Lucas-byte31/Greenhouse/02_SW_SPEC/Schema de cablage.pptx

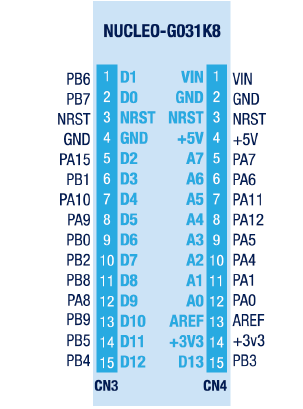
[picture p20: figure]

Écran LCD

PB6 et PB7 (GPIO OUT)

Alimentation 5VDC

Écran LCD

PB1 (GPIO OUT)

PB1

PB2

PA7 (GPIO IN)

IN1

Carte moteur

IN3

IN4

De PB9

De PB5

Capteur Température

Capteur Humidité

PB3

PA6 (GPIO IN)

PA11 (GPIO IN)

IN2

Écran LCD

PB0, PB2 et PB8
(GPIO OUT)

Vers IN3

PA1 (ADC1_IN1)

Pompe

Ventilateur

Vers IN4

Vers IN3

PA0 (ADC1_IN0)

PB4 (GPIO OUT)

PB3 (GPIO OUT)

## Slide 2

Carte moteur SBC-MotorDriver2

FAN

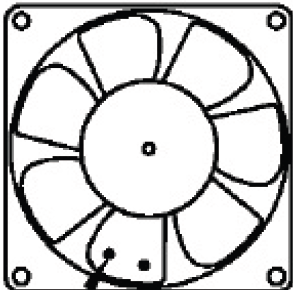
[picture p21: figure]

+

GND

GND

+

GPIO_OUT

PWM (TIM16_CH1)

+

GND

IN1

IN2

IN3

IN4

Alim 5-12V

## Slide 3

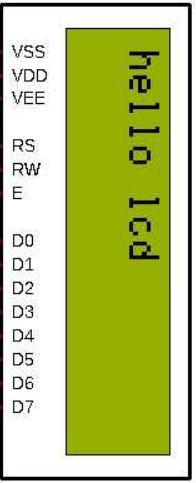
[picture p22: figure]

A

K
