Lucas-byte31/Greenhouse/02_SW_SPEC/Matériel.xlsx

Projet Greenhouse - Serre connectée
composants utilisés: | Composant | Référence | Alimentation | Courant d'usage
 | Microprocesseur | stm32g031k8 | 1.7 - 3.6V | 20mA max / broche
 | Capteur d’humidité Type SeedStudio | 101020614 | 3.3 - 5V | -
 | Capteur de température | Basé LM35, DHT22, thermistance ou équivalent | 2.3 - 5.5V | -
 | Ecran | HD44780U LCD 2x16 parallèle ou équivalent | 2.7 - 4.5V | 150mA
 | Pompe à eau | FIT0910 | 3 - 6 V | 150 - 370mA
 | Ventilateur | MF40100V2 | 3.5 - 6V | 155 - 179mA
 | Carte moteur | MotoDriver2 (5V-24V, double canal, contrôle digital) | 5 - 35V | 2A Max
 | Boutons poussoirs
 | (3+)
 | Alimentation
 | Connecteurs
