Lucas-byte31/Greenhouse/04_SW_CODE/MX_Project/Core/Src/main.c

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
/* Includes ------------------------------------------------------------------*/
#include "main.h"

/* USER CODE BEGIN Includes */
#include <motor_driver_fan.h>
#include <motor_driver_pump.h>
#include "capteurs.h"
#include "lcd.h"
#include "lcd_page_manager.h"
#include "filter.h"
#include "error_handler.h"
#include <stdio.h>
#include <stdlib.h>
#include <string.h>
/* USER CODE END Includes */

/* USER CODE BEGIN PD */

/* Calibration humidite SEN0193 - base DFRobot adaptée en 12 bits */

/* USER CODE END PD */

ADC_HandleTypeDef hadc1;

TIM_HandleTypeDef htim3;

UART_HandleTypeDef huart2;

//Flags d'interruption pour les boutons poussoir : mis à TRUE par IT GPIO
// Mis à FALSE par le main
volatile bool PB1_pressed = false;   // Flag PB1 - Bouton rouge - navigation dans les menus
volatile bool PB2_pressed = false;   // Flag PB2 - Bouton blanc - Incrémentation consigne ou Forcage manuel
volatile bool PB3_pressed = false;   // Flag PB3 - Bouton vert - Décrémentation consigne ou Forcage manuel
void SystemClock_Config(void);
static void MX_GPIO_Init(void);
static void MX_USART2_UART_Init(void);
static void MX_ADC1_Init(void);
static void MX_TIM3_Init(void);
/* USER CODE BEGIN PFP */
void HAL_TIM_MspPostInit(TIM_HandleTypeDef *htim); //prototype de HAL_TIM_MspPostInit pour éviter warning

float TMP235_linear(float voltage);
float humidity_from_raw(uint32_t raw);
uint32_t ReadADC_Channel(uint32_t channel);

#define V_REF      3.3f		 // Vref 3.3V
#define V_OFFSET   0.130f    // offset mesure a 0V

#define AIR_VALUE   2675.0f  // mesure en air sec
#define WATER_VALUE 1780.0f  // mesure dans l'eau
/* USER CODE END PFP */

/* USER CODE BEGIN 0 */

static lcd_state_t lcd_prev = {0};
static lcd_state_t lcd_curr = {0};

/* USER CODE END 0 */

/**
  * @brief  The application entry point.
  * @retval int
  */
int main(void)
{

  /* MCU Configuration--------------------------------------------------------*/

  /* Reset of all peripherals, Initializes the Flash interface and the Systick. */
  HAL_Init();

  /* Configure the system clock */
  SystemClock_Config();

  /* Initialize all configured peripherals */
  MX_GPIO_Init();
  MX_USART2_UART_Init();
  MX_ADC1_Init();
  MX_TIM3_Init();

  /* USER CODE BEGIN 2 */

  // On initialise le moteur a OFF
  Motor_Off();
  // On initialise la pompe a OFF
  Pump_Init(); // init de la pompe
  
  //--Paramètres de régulation par défaut--//
  static int Var_page = 1; // page affichée au démarrage
  static int seuil_temperature = 25;  // Seuil de température par défaut
  static int seuil_humidite = 18;     // Seuil d'humidité par défaut
  static int code_erreur = 0; //init du code erreur à 0
  uint8_t speed = 0;  // Variable pour la vitesse de la pompe (0-100) en %


  //--Configuration du PWM pour la pompe--//
  //--Calcul de la rampe linéaire à l'approche du seuil d'humidité--//
  float x1 = 0.55f;  // 0.55*seuil_humidite → speed = 100
  float y1 = 100.0f;
  float x2 = 1.0f;  // 1.0*seuil_humidite → speed = 50
  float y2 = 50.0f;
  // Calcul des coefficients m et b de la droite y = mx + b
  float m = (y2 - y1) / (x2 - x1);
  float b = y1 - m * x1;

  // Initialisation LCD
  lcd_init();
  lcd_clear();
  static uint32_t last_lcd_update = 0;

  // Affichage
  lcd_position_cursor(0,0);
  lcd_show_txt("HELLO WORLD");

  lcd_position_cursor(0,1);
  lcd_show_txt("STM32G031U");

  // Pour debug avec printf -- pas besoin en opérationnel
  /*char buffert[80];
  char bufferh[80];*/



 //- Filtrage sur moyenne glissante pour éviter le clear intempestif du LCD --//
  // Init Moyenne glissante
  static int t_display = 0; // température affichée
  static int h_display = 0; // humidité affichée

  #define TEMP_DEADBAND 1 // 1 °C de DEADBAND
  #define HUM_DEADBAND  2 // 2 % de DEADBAND

  moving_avg_filter_t temp_filter;
  moving_avg_filter_t hum_filter;
  //Moyenne glissante sur 8 échantillons pour stabiliser l'affichage sur le LCD
  filter_init(&temp_filter, 8, seuil_temperature); //init du filtre au seuil_temperature
  filter_init(&hum_filter, 8, seuil_humidite); //init du filtre au seuil humidite

  	 // Init de l'Error Handler
  error_handler_init(seuil_temperature, seuil_humidite); // Init de l'error handler
  /* USER CODE END 2 */

  /* Infinite loop */
  /* USER CODE BEGIN WHILE */
  while (1)
  {

	  // Connaitre l'instant présent - utilisé dans l'error handler et dans le rafraichissement du LCD
      uint32_t now = HAL_GetTick();

	  /* ================== HUMIDITE sur PA0 = ADC1_IN0 ================== */
	      uint32_t raw_hum = ReadADC_Channel(ADC_CHANNEL_0);
	      float humidity = CAPTEURS_ComputeHumidity(raw_hum, AIR_VALUE, WATER_VALUE);

	      int h100 = (int)(humidity * 100.0f);
	      int h_int = h100 / 100;
	      //int h_dec = abs(h100 % 100); //utilisée que pour le debug

	      /*Pour le debug
	      sprintf(bufferh,
	              "H: rawHum=%lu  Humidite=%d.%02d %%\r\n",
	              raw_hum, h_int, h_dec);
	      HAL_UART_Transmit(&huart2, (uint8_t*)bufferh, strlen(bufferh), HAL_MAX_DELAY);*/


	      /* ============== TEMPERATURE sur PA1 = ADC1_IN1 (TMP235) ============== */
	      uint32_t raw_temp = ReadADC_Channel(ADC_CHANNEL_1);
	      float temperature = CAPTEURS_ComputeTemperature(raw_temp, V_REF, V_OFFSET);

	      int t100 = (int)(temperature * 100.0f);
	      int t_int = t100 / 100;
	      //int t_dec = abs(t100 % 100); //utilisée que pour le debug

	      /*Pour le debug
	      sprintf(buffert,
	              "T: raw=%lu  T=%d.%02d C\r\n",
	              raw_temp, t_int, t_dec);
	      HAL_UART_Transmit(&huart2, (uint8_t*)buffert, strlen(buffert), HAL_MAX_DELAY);*/


	      // ===================== Filtrage numérique Temperature et Humidite =====================
	      /* Un filtrage logiciel par moyenne glissante permet de supprimer le bruit des capteurs
	      tout en conservant une information pertinente pour l’utilisateur, sans bloquer l’exécution du système. */
	      int t_filt = filter_update(&temp_filter, t_int);
	      int h_filt = filter_update(&hum_filter, h_int);


	      /* --- Température --- */
	      if (abs(t_filt - t_display) >= TEMP_DEADBAND)
	      {
	          t_display = t_filt;
	      }

	      /* --- Humidité --- */
	      if (abs(h_filt - h_display) >= HUM_DEADBAND)
	      {
	          h_display = h_filt;
	      }


	      // ===================== Asservissement de la Ventilation en Automatique =====================
	      // Le contrôle est actif seulement si on n'est pas sur la Page 4 (Mode Manuel)
	      if (Var_page != 4)
	      {
	    	  if (temperature >= seuil_temperature)
	    	  {
	              Motor_On();
	    	  } else if (temperature < (seuil_temperature - 0.5f))
	    		  // petite hysteresis pour éviter que
	    		  // le ventilateur démmarre et s'arrête en permanence quand temperature oscille sur seuil_temperature
	    	  {
	    	  	  Motor_Off();
	    	  }

	      // ===================== Asservissement de la Pompe en Automatique =====================

	    	  // Asservissement linéaire
	    	  //Plus l'humidité est éloignée de sa consigne, plus la pompe tourne à haute vitesse
	    	  //Plus l'humidité s'approche de sa valeur consigne, moins la pompe tourne

	    	  // Calcul du ratio humidité courante / consigne pour la loi PWM
	    	  float humidity_ratio = (float)humidity / seuil_humidite;

	    	  // Application de l'équation de droite
	    	  if (humidity_ratio <= x1) // Zone 1 : Besoin critique (100% PWM)
	    	  {
	    	      speed = 100;  // Vitesse max si humidity <= 0.55*seuil_humidite
	    	  }
	    	  else if (humidity_ratio <= x2) // Zone 2 : Régulation douce (Approche)
	    	  {
	    	      speed = (uint8_t)(m * humidity_ratio + b);  // Rampe linéaire
	    	  }
	    	  else // Zone 3 : Consigne atteinte
	    	  {
	    	      speed = 0;  // Pompe éteinte si humidity > 0.999*seuil_humidite
	    	      Pump_Stop();
	    	  }
	    	  	Pump_SetSpeed(speed);

	      } else {
	    	  // Ne rien faire
	      }



	      // ===================== Changement de page si PB1 appuyé =====================
	      if (PB1_pressed)
	      {
	          PB1_pressed = false;       // on consomme l'événement

	          Var_page++;
	          if (Var_page > 5)
	              Var_page = 1;          // retour à la page 1
	      }


	      // ===================== Mise à jour de l'etat courant de la structure lcd_state_t =====================
	      lcd_curr.page = Var_page;
	      lcd_curr.t_filt = t_display;
	      lcd_curr.h_filt = h_display;
	      lcd_curr.seuil_temperature = seuil_temperature;
	      lcd_curr.seuil_humidite = seuil_humidite;
	      lcd_curr.code_erreur = code_erreur;
	      lcd_curr.pump_on = Pump_IsOn();
	      lcd_curr.fan_on = Motor_IsOn();




	      // ===================== Gestion de l'affichage (500ms) =====================
	      // Boucle principale de l'affichage LCD

	      // Le rafraîchissement est cadencé pour éviter les scintillements de l'écran
	      if ((now - last_lcd_update) >= 500)   // 500 ms = confort visuel
	          {
	              last_lcd_update = now;

	              // ===================== Mise à jour de l'écran LCD uniquement sur évênement =====================
	              // On compare l'état actuel (lcd_curr) avec l'état précédent (lcd_prev)
	              switch (Var_page)
	              {
	              case 1:
	            	  // -------- PAGE 1 --------
	            	  // Temperature     x°C
	            	  // Humidite        x%

	            	  lcd_page_1(&lcd_curr, &lcd_prev);

	                 break;

	              case 2:
	            	  // -------- PAGE 2 --------
	            	  // Temperature     x°C
	            	  // Seuil           x°C -- limité 0 -> 51°C

	            		  if (PB2_pressed && !PB3_pressed)
	            		 {
	            		  PB2_pressed = false;       // on consomme l'événement
	            		  if (seuil_temperature < 51) seuil_temperature  += 1;// + 1
	            		 }
	            		 if (PB3_pressed && !PB2_pressed)
	            		 {
	            		  PB3_pressed = false;       // on consomme l'événement
	            		  if (seuil_temperature > 0) seuil_temperature -= 1; // - 1
	            		 }
	            	  lcd_page_2(&lcd_curr, &lcd_prev);

	                 break;

	              case 3:
	            	  // -------- PAGE 3 --------
	            	  // Humidite        x%
	            	  // Seuil           x% -- limité 0 -> 100%

	            	  if (PB2_pressed && !PB3_pressed )
	            	  {
	            		  PB2_pressed = false;       // on consomme l'événement
	            		  if (seuil_humidite < 100) seuil_humidite += 1; // +1
	            	  }
	            	  if (PB3_pressed && !PB2_pressed )
	            	  {
	            		  PB3_pressed = false;       // on consomme l'événement
	            		  if (seuil_humidite > 0) seuil_humidite -= 1; // -1
	            	  }

	            	  lcd_page_3(&lcd_curr, &lcd_prev);

	                 break;

	              case 4:
	            	  // -------- PAGE 4 --------
	            	  // Pompe       ON/OFF
	            	  // Ventilateur ON/OFF

	            	  // ===================== Ventilateur Manuel=====================
	            	  if (PB2_pressed)
	            	  {
	            		  PB2_pressed = false;   // On remet PB à false
	            		  if (Motor_IsOn()) // si le moteur est déjà allumé on l'éteind
	            			  Motor_Off();
	            		  else				// si le moteur est éteind on l'allume
	            			  Motor_On();
	            	  }

	            	  // ===================== Pompe Manuelle=====================
	            	  if (PB3_pressed)
	            	  {
	            		  PB3_pressed = false;   // On remet PB à false
	            		  if (Pump_IsOn())		// si la pompe est déjà allumé on l'éteind
	            			  Pump_Stop();
	            		  else
	            			  Pump_SetSpeed(100);   // // si la pompe est éteinte on l'allume à 100% PWM
	            	  }

	            	  lcd_page_4(&lcd_curr, &lcd_prev);

	                 break;

	              case 5:
	              	  // -------- PAGE 5 -------- MAINTENANCE
	      			// SYSTEME OK
	      			// FAN SYSTEM OK/KO
	      			// PUMP SYSTEM OK/KO
	            	  	  code_erreur = error_handler_has_error(); // mise à jour du code erreur
	              	      lcd_page_5(&lcd_curr, &lcd_prev);

	              	 break;

	              }
	          }

	      //Gestion des erreurs
	      error_handler_update(
	          t_filt,
	          h_filt,
			  seuil_temperature,
			  seuil_humidite,
	          Motor_IsOn(),
	          Pump_IsOn(),
	          now
	      );

	      /*Pour le debug
	      sprintf(bufferh,
	              "ErrorHandlerHasError: %d\r\n",
				  error_handler_has_error());
	      HAL_UART_Transmit(&huart2, (uint8_t*)bufferh, strlen(bufferh), HAL_MAX_DELAY);*/
    /* USER CODE END WHILE */

    /* USER CODE BEGIN 3 */
  }
  /* USER CODE END 3 */
}

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
/* USER CODE BEGIN 4 */
// Fonction pour faire blinker la LED du STM32
void LED_BLINK(uint32_t blink_period_ms)
{
    static uint32_t last_toggle = 0;
    uint32_t now = HAL_GetTick();

    if ((now - last_toggle) >= blink_period_ms) // Check du temps
    {
        last_toggle = now;
        HAL_GPIO_TogglePin(LD3_GPIO_Port, LD3_Pin); // Change l'état de la LED
    }
}


// Interruption
void HAL_GPIO_EXTI_Rising_Callback(uint16_t GPIO_Pin)
{
    // Anti-rebond logiciel : On ignore les impulsions parasites < 200ms
    // générées par le contact mécanique des bouton
    static uint32_t last_interrupt_time = 0;
    uint32_t now = HAL_GetTick();
    if (now - last_interrupt_time < 200) return;  // 200 ms debounce
    last_interrupt_time = now;

    if (GPIO_Pin == PUSH_BUTTON1_Pin)
    {
        PB1_pressed = true;   // Flag PB1
    }

    if (GPIO_Pin == PUSH_BUTTON2_Pin)
    {
        PB2_pressed = true;   // Flag PB2
    }

    if (GPIO_Pin == PUSH_BUTTON3_Pin)
    {
        PB3_pressed = true;   // Flag PB3
    }
}

/* Lecture d un canal ADC1 par polling */
// Pas besoin d'interruption pour l'ADC car les mesures sont lentes (température et humidité)
uint32_t ReadADC_Channel(uint32_t channel)
{
    ADC_ChannelConfTypeDef sConfig = {0};

    //Configuration du channel
    sConfig.Channel      = channel;
    sConfig.Rank         = ADC_REGULAR_RANK_1; // Priorité 1
    sConfig.SamplingTime = ADC_SAMPLINGTIME_COMMON_1; // Temps d'échantillonnage

    // Application de la configuration sur ADC1
    HAL_ADC_ConfigChannel(&hadc1, &sConfig);

    // Conversion
    HAL_ADC_Start(&hadc1);

    //Attente fin de conversion
    HAL_ADC_PollForConversion(&hadc1, 100);

    //Retour de la valeur ADC lue
    return HAL_ADC_GetValue(&hadc1);
}




/* USER CODE END 4 */
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
