Lucas-byte31/Greenhouse/04_SW_CODE/MX_Project/Core/Inc/main.h

#define GPIO_POMPE_Pin GPIO_PIN_9
#define GPIO_POMPE_GPIO_Port GPIOB
#define T_NRST_Pin GPIO_PIN_2
#define T_NRST_GPIO_Port GPIOF
#define T_VCP_TX_Pin GPIO_PIN_2
#define T_VCP_TX_GPIO_Port GPIOA
#define T_VCP_RX_Pin GPIO_PIN_3
#define T_VCP_RX_GPIO_Port GPIOA
#define PUSH_BUTTON2_Pin GPIO_PIN_6
#define PUSH_BUTTON2_GPIO_Port GPIOA
#define PUSH_BUTTON2_EXTI_IRQn EXTI4_15_IRQn
#define PUSH_BUTTON1_Pin GPIO_PIN_7
#define PUSH_BUTTON1_GPIO_Port GPIOA
#define PUSH_BUTTON1_EXTI_IRQn EXTI4_15_IRQn
#define LD3_Pin GPIO_PIN_6
#define LD3_GPIO_Port GPIOC
#define PUSH_BUTTON3_Pin GPIO_PIN_11
#define PUSH_BUTTON3_GPIO_Port GPIOA
#define PUSH_BUTTON3_EXTI_IRQn EXTI4_15_IRQn
#define T_JTMS_Pin GPIO_PIN_13
#define T_JTMS_GPIO_Port GPIOA
#define T_JTCK_Pin GPIO_PIN_14
#define T_JTCK_GPIO_Port GPIOA
#define MOTOR_IN1_Pin GPIO_PIN_3
#define MOTOR_IN1_GPIO_Port GPIOB
#define MOTOR_IN2_Pin GPIO_PIN_4
#define MOTOR_IN2_GPIO_Port GPIOB
#define PWM_POMPE_Pin GPIO_PIN_5
#define PWM_POMPE_GPIO_Port GPIOB
