Lucas-byte31/Greenhouse/04_SW_CODE/MX_Project/Core/Src/motor_driver_fan.c

/*
 * motor_driver.c
 *
 *  Created on: Nov 14, 2025
 *      Author: lucas
 */

// Include de motor_driver
#include "motor_driver_fan.h"

// Global data declaration et affectation
// Etat du moteur: OFF =0 et ON =1
static uint8_t G_MotorState = 0;

//Activation du ventilateur
void Motor_On(void)
{
    // Rotation du Moteur : IN1 = 1 et IN2 = 0
    HAL_GPIO_WritePin(MOTOR_IN1_GPIO_Port, MOTOR_IN1_Pin, GPIO_PIN_SET);
    HAL_GPIO_WritePin(MOTOR_IN1_GPIO_Port, MOTOR_IN2_Pin, GPIO_PIN_RESET);
    G_MotorState = 1;
}

//Arrêt du ventilateur
void Motor_Off(void)
{
    // Arrêt du Moteur : IN1 = 0 et IN2 = 0
    HAL_GPIO_WritePin(MOTOR_IN1_GPIO_Port, MOTOR_IN1_Pin, GPIO_PIN_RESET);
    HAL_GPIO_WritePin(MOTOR_IN1_GPIO_Port, MOTOR_IN2_Pin, GPIO_PIN_RESET);
    G_MotorState = 0;
}

//Retour sur l'état du ventilateur
uint8_t Motor_IsOn(void)
{
    return G_MotorState;
}
