Lucas-byte31/Greenhouse/04_SW_CODE/MX_Project/Core/Inc/motor_driver_fan.h

/*
 * motor_drvier.h
 *
 *  Created on: Nov 14, 2025
 *      Author: lucas
 */

#ifndef INC_MOTOR_DRIVER_FAN_H_
#define INC_MOTOR_DRIVER_FAN_H_

#include "main.h"

// Declaration des fonctions de motor_driver
void Motor_On(void);
void Motor_Off(void);
uint8_t Motor_IsOn(void);


#endif /* INC_MOTOR_DRIVER_FAN_H_ */
