Lucas-byte31/Greenhouse/(commit log)

2025-10-29 Specification delivery
    [Matériel.xlsx]
2025-10-29 Create Schema de cablage.pptx
2025-10-29 Update Schema de cablage.pptx
2025-11-06 note de cadrage
2025-11-14 test I2c
2025-11-14 I2C retiré
2025-11-27 Add sensors and pump
2025-11-27 add LCD algo
    [Matériel.xlsx]
