Lucas-byte31/Greenhouse/(notices)

Notices in the files:
04_SW_CODE/MX_Project/Core/Inc/main.h:
Copyright (c) 2025 STMicroelectronics.
All rights reserved.
This software is licensed under terms that can be found in the LICENSE file
